evv42/nenemark2/nenescm.pdf

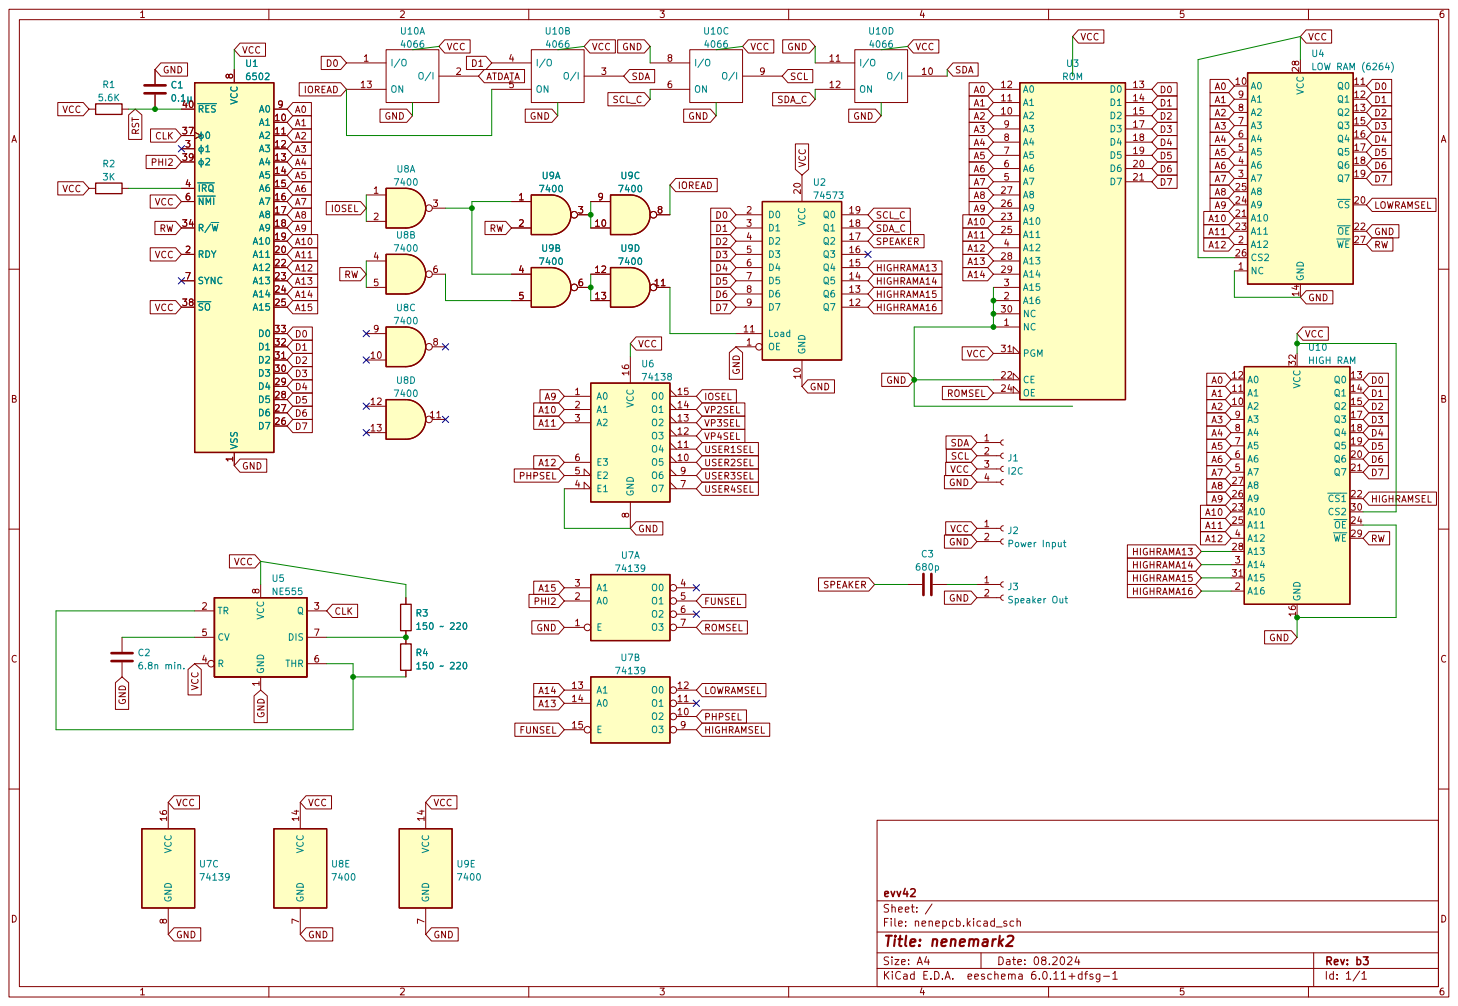
[picture p1: page 1]

File: nenepcb.kicad_sch Sheet: / evv42 VCC 14 GND
