evv42/nenemark2/(commit log)

2024-07-19 fix i2c init
2024-08-01 slightly better schematics
